RyanHailey21/neuromorphic-IR-hand-assembled/docs/images/board_iso.png

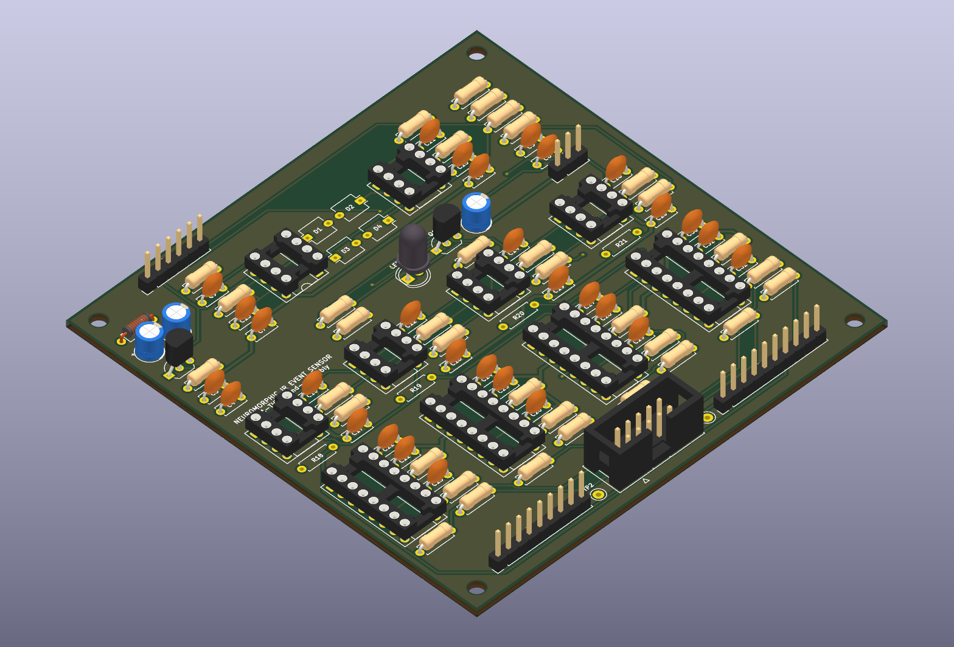
docs/images/board_iso.png
