RyanHailey21/neuromorphic-IR-hand-assembled/production/neuromorphic-ir-sensor-tht-BOM.csv

Qty | Value | References | Part / MPN | Function | Footprint | DNP
3 | 10uF | C1,C2,C33 | 10uF 16V radial electrolytic | Analog bulk,LED local bulk,Logic / one-shot bulk | Capacitor_THT:CP_Radial_D5.0mm_P2.00mm
1 | 1uF | C3 | 1uF X7R radial | Reference decoupling | Capacitor_THT:C_Disc_D5.0mm_W2.5mm_P5.00mm
17 | 100nF | C4-C8,C10,C12,C14,C16-C21,C24,C27,C30 |  | Adaptation CA (swap 47n/220n),Reference decoupling,Threshold filter,U10 decoupling,U11 decoupling,U2 decoupling,U3 decoupling,U4 decoupling,U5 decoupling,U6 decoupling,U7 decoupling,U8 decoupling,U9 decoupling | Capacitor_THT:C_Disc_D5.0mm_W2.5mm_P5.00mm
4 | 47pF C0G | C9,C11,C13,C15 | 47pF C0G radial | TIA feedback CF | Capacitor_THT:C_Disc_D5.0mm_W2.5mm_P5.00mm
8 | 12nF C0G | C22,C23,C25,C26,C28,C29,C31,C32 | 12nF C0G radial or film | One-shot timing C | Capacitor_THT:C_Disc_D5.0mm_W2.5mm_P5.00mm
4 | BPW34F | D1-D4 | ams OSRAM BPW 34 F (THT, daylight filter); alt Vishay BPW34 | IR photodiode BL (cathode to TIA input),IR photodiode BR (cathode to TIA input),IR photodiode TL (cathode to TIA input),IR photodiode TR (cathode to TIA input) | OptoDevice:Osram_DIL2_4.3x4.65mm_P5.08mm
1 | 600R@100MHz | FB1 | Axial ferrite bead (e.g. Fair-Rite 2743001112) | Analog rail filter bead | Inductor_THT:L_Axial_L5.3mm_D2.2mm_P7.62mm_Horizontal_Vishay_IM-1
1 | FPGA | J1 | 2x5 2.54mm shrouded box header | Keyed 2x5 event header to Tang Nano 20K | Connector_IDC:IDC-Header_2x05_P2.54mm_Vertical
1 | DEBUG | J2 |  | Analog debug header | Connector_PinHeader_2.54mm:PinHeader_1x06_P2.54mm_Vertical
1 | LED_EN | J3 |  | Jumper 1-2 = LED on, 2-3 = off, or drive pin 2 from FPGA | Connector_PinHeader_2.54mm:PinHeader_1x03_P2.54mm_Vertical
1 | RAW_PROBE | J4 |  | Raw comparator probe header | Connector_PinHeader_2.54mm:PinHeader_1x09_P2.54mm_Vertical
1 | EVENT_PROBE | J5 |  | Rail / threshold / event-node probe header | Connector_PinHeader_2.54mm:PinHeader_1x10_P2.54mm_Vertical
1 | TSAL6200 | LED1 | Vishay TSAL6200 | 940 nm IR emitter | LED_THT:LED_D5.0mm_IRGrey
1 | PN2222A | Q1 | PN2222A | LED low-side switch | Package_TO_SOT_THT:TO-92_Inline_Wide
1 | 4.7k | R1 |  | Reference bias ~0.44 mA | Resistor_THT:R_Axial_DIN0207_L6.3mm_D2.5mm_P7.62mm_Horizontal
1 | 499k 0.1% | R2 |  | ON threshold upper | Resistor_THT:R_Axial_DIN0207_L6.3mm_D2.5mm_P7.62mm_Horizontal
2 | 10k 0.1% | R3,R4 |  | OFF threshold upper,ON threshold lower | Resistor_THT:R_Axial_DIN0207_L6.3mm_D2.5mm_P7.62mm_Horizontal
1 | 301k 0.1% | R5 |  | OFF threshold lower | Resistor_THT:R_Axial_DIN0207_L6.3mm_D2.5mm_P7.62mm_Horizontal
4 | 18k 0.1% | R6,R9,R12,R15 |  | TIA feedback RF | Resistor_THT:R_Axial_DIN0207_L6.3mm_D2.5mm_P7.62mm_Horizontal
4 | 22k | R7,R10,R13,R16 |  | Adaptation RA (swap 10k/47k) | Resistor_THT:R_Axial_DIN0207_L6.3mm_D2.5mm_P7.62mm_Horizontal
4 | 100 | R8,R11,R14,R17 |  | Debug header series R | Resistor_THT:R_Axial_DIN0207_L6.3mm_D2.5mm_P7.62mm_Horizontal
4 | 1M | R18-R21 |  | Optional ON hysteresis (DNP) | Resistor_THT:R_Axial_DIN0207_L6.3mm_D2.5mm_P7.62mm_Horizontal | DNP
8 | 18k | R22,R24,R26,R28,R30,R32,R34,R36 |  | One-shot timing R (~100 us) | Resistor_THT:R_Axial_DIN0207_L6.3mm_D2.5mm_P7.62mm_Horizontal
8 | 150 | R23,R25,R27,R29,R31,R33,R35,R37 |  | Spike series R | Resistor_THT:R_Axial_DIN0207_L6.3mm_D2.5mm_P7.62mm_Horizontal
1 | 82 | R38 |  | LED current (~22 mA) - tuning 68/100/150 | Resistor_THT:R_Axial_DIN0207_L6.3mm_D2.5mm_P7.62mm_Horizontal
1 | 1k | R39 |  | Base resistor | Resistor_THT:R_Axial_DIN0207_L6.3mm_D2.5mm_P7.62mm_Horizontal
1 | 100k | R40 |  | LED_EN pulldown | Resistor_THT:R_Axial_DIN0207_L6.3mm_D2.5mm_P7.62mm_Horizontal
2 | GND | TP1,TP2 |  | Scope ground loop | TestPoint:TestPoint_Keystone_5000-5004_Miniature
1 | LM385BZ-1.2 | U1 | LM385BZ-1.2 | 1.235 V shunt reference (VREF) | Package_TO_SOT_THT:TO-92_Inline_Wide
2 | MCP6022 | U2,U3 | MCP6022-I/P | Dual RRIO CMOS op-amp (TIA) | Package_DIP:DIP-8_W7.62mm_Socket
4 | MCP6542 | U4-U7 | MCP6542-I/P | Dual push-pull comparator, ON (A) / OFF (B) | Package_DIP:DIP-8_W7.62mm_Socket
4 | 74HC123 | U8-U11 | 74HC123 (SN74HC123N / 74HC123N) | Dual retriggerable monostable, ON (A) / OFF (B) | Package_DIP:DIP-16_W7.62mm_Socket
