RyanHailey21/neuromorphic-IR-hand-assembled/docs/schematic.pdf

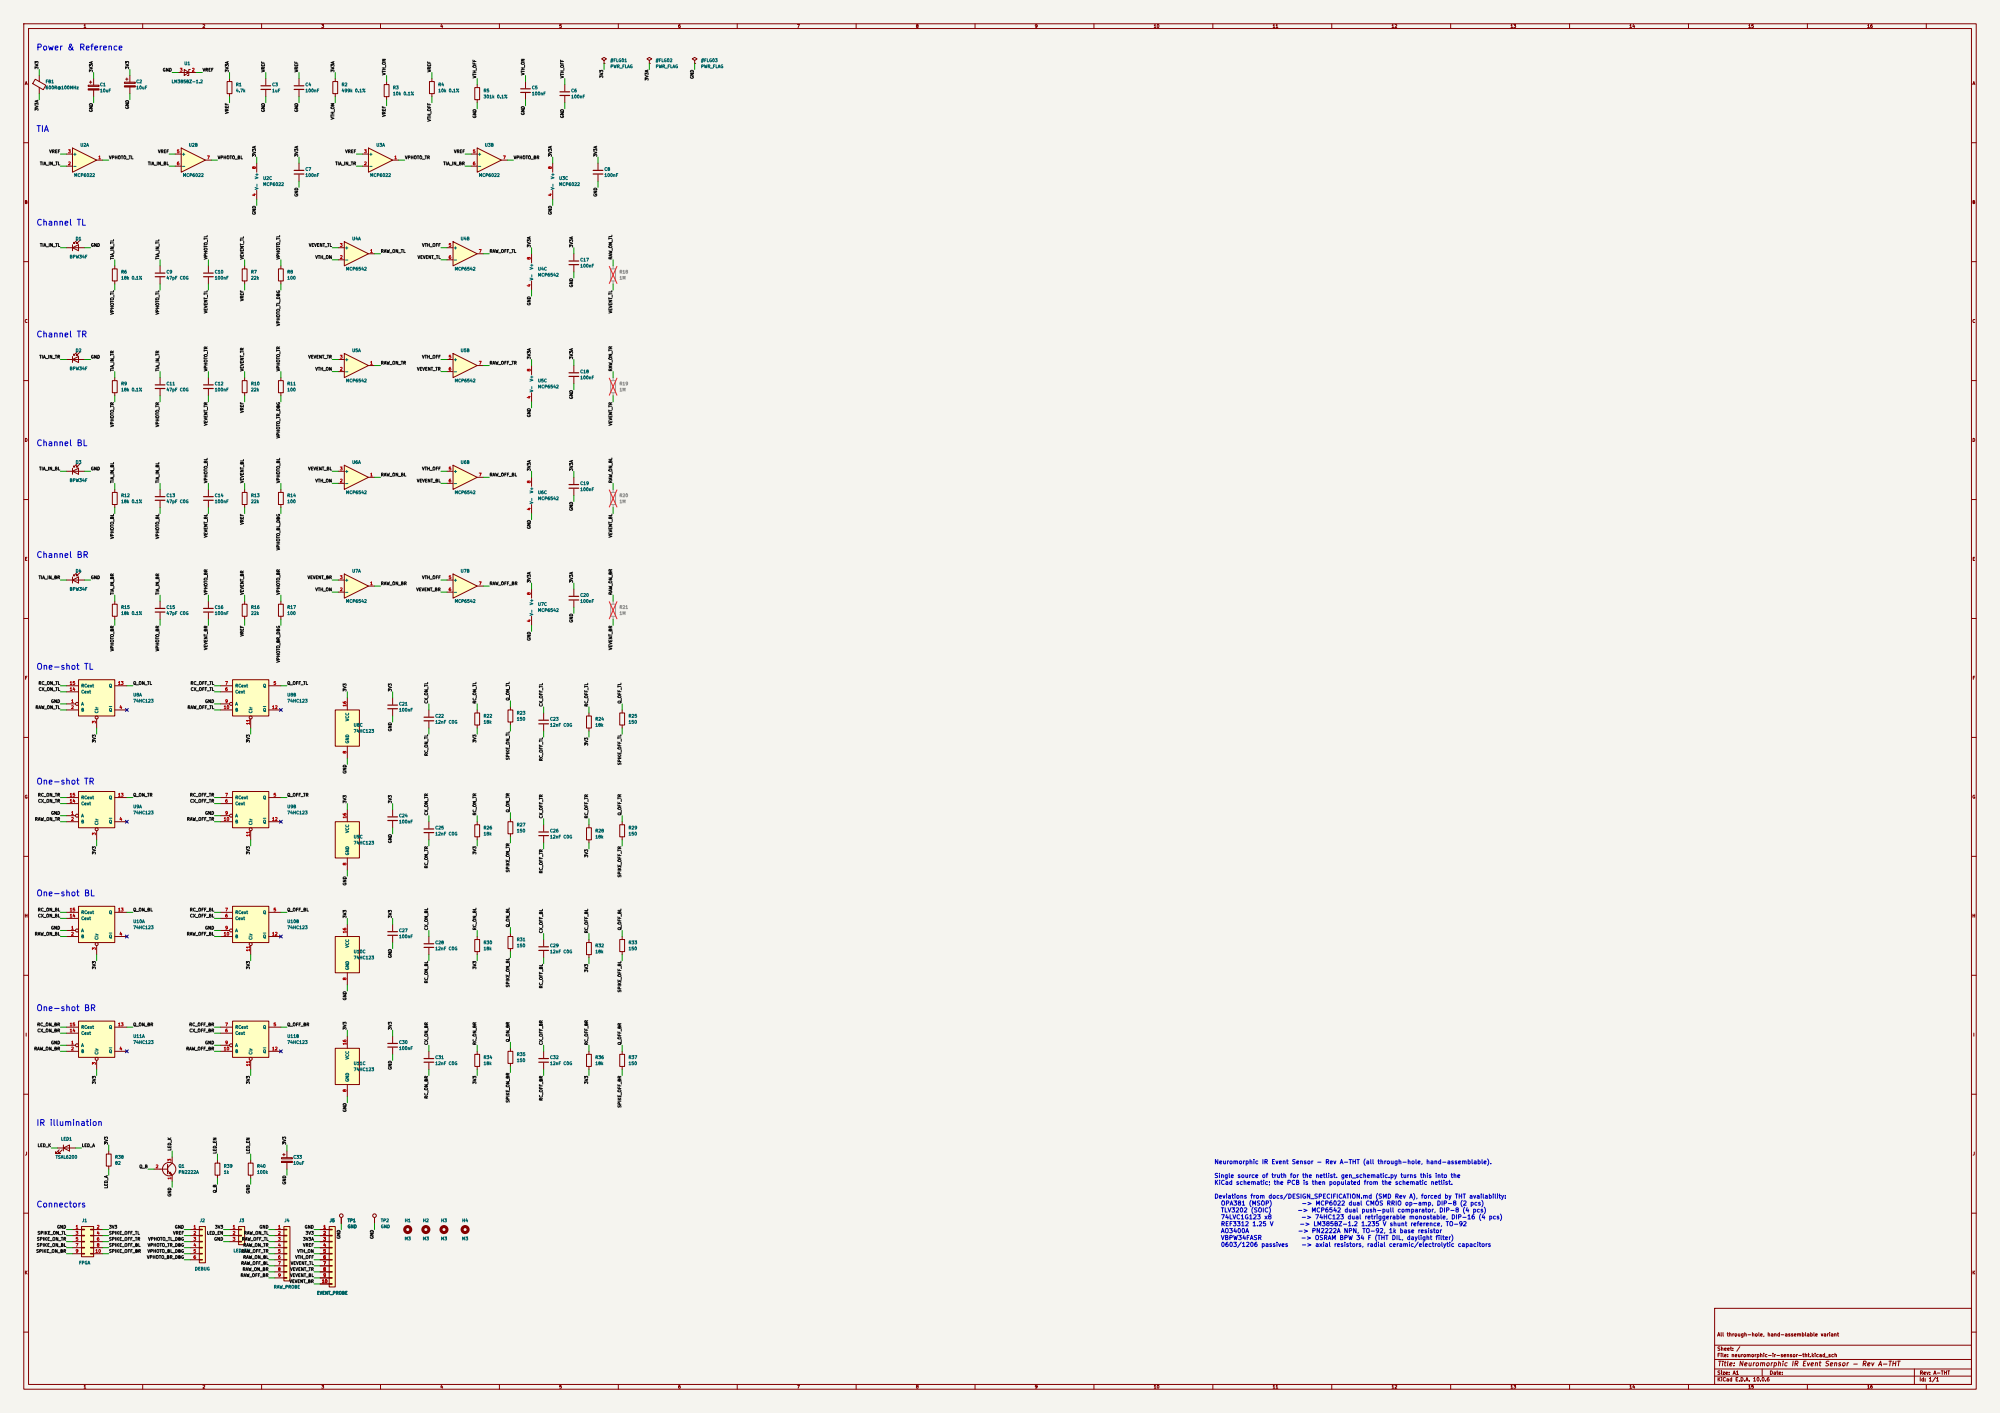
[picture p3: page 1]

Neuromorphic IR Event Sensor - Rev A-THT (all through-hole, hand-assemblable).

Single source of truth for the netlist. gen_schematic.py turns this into the
KiCad schematic; the PCB is then populated from the schematic netlist.

Deviations from docs/DESIGN_SPECIFICATION.md (SMD Rev A), forced by THT availability:

All through-hole, hand-assemblable variant

Sheet: /
File: neuromorphic-ir-sensor-tht.kicad_sch
Title: Neuromorphic IR Event Sensor - Rev A-THT

Size: A1 | Rev: A-THT
KiCad E.D.A. 10.0.6 | Id: 1/1
