RyanHailey21/neuromorphic-IR-hand-assembled/docs/assembly_top.pdf

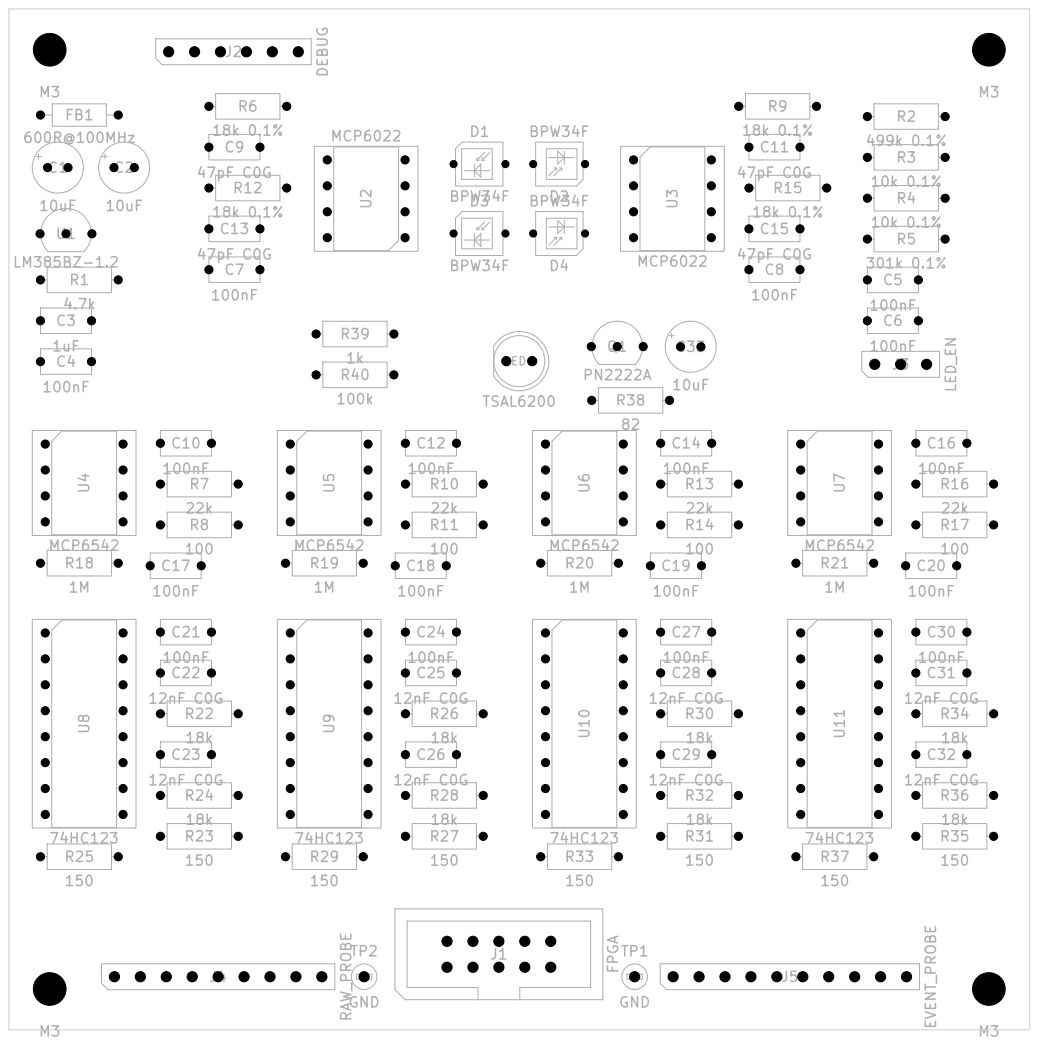
[picture p4: page 1]
