RyanHailey21/neuromorphic-IR-hand-assembled/neuromorphic-ir-sensor-tht.kicad_pcb

## KiCad design neuromorphic-ir-sensor-tht.kicad_pcb (2026-09-27)

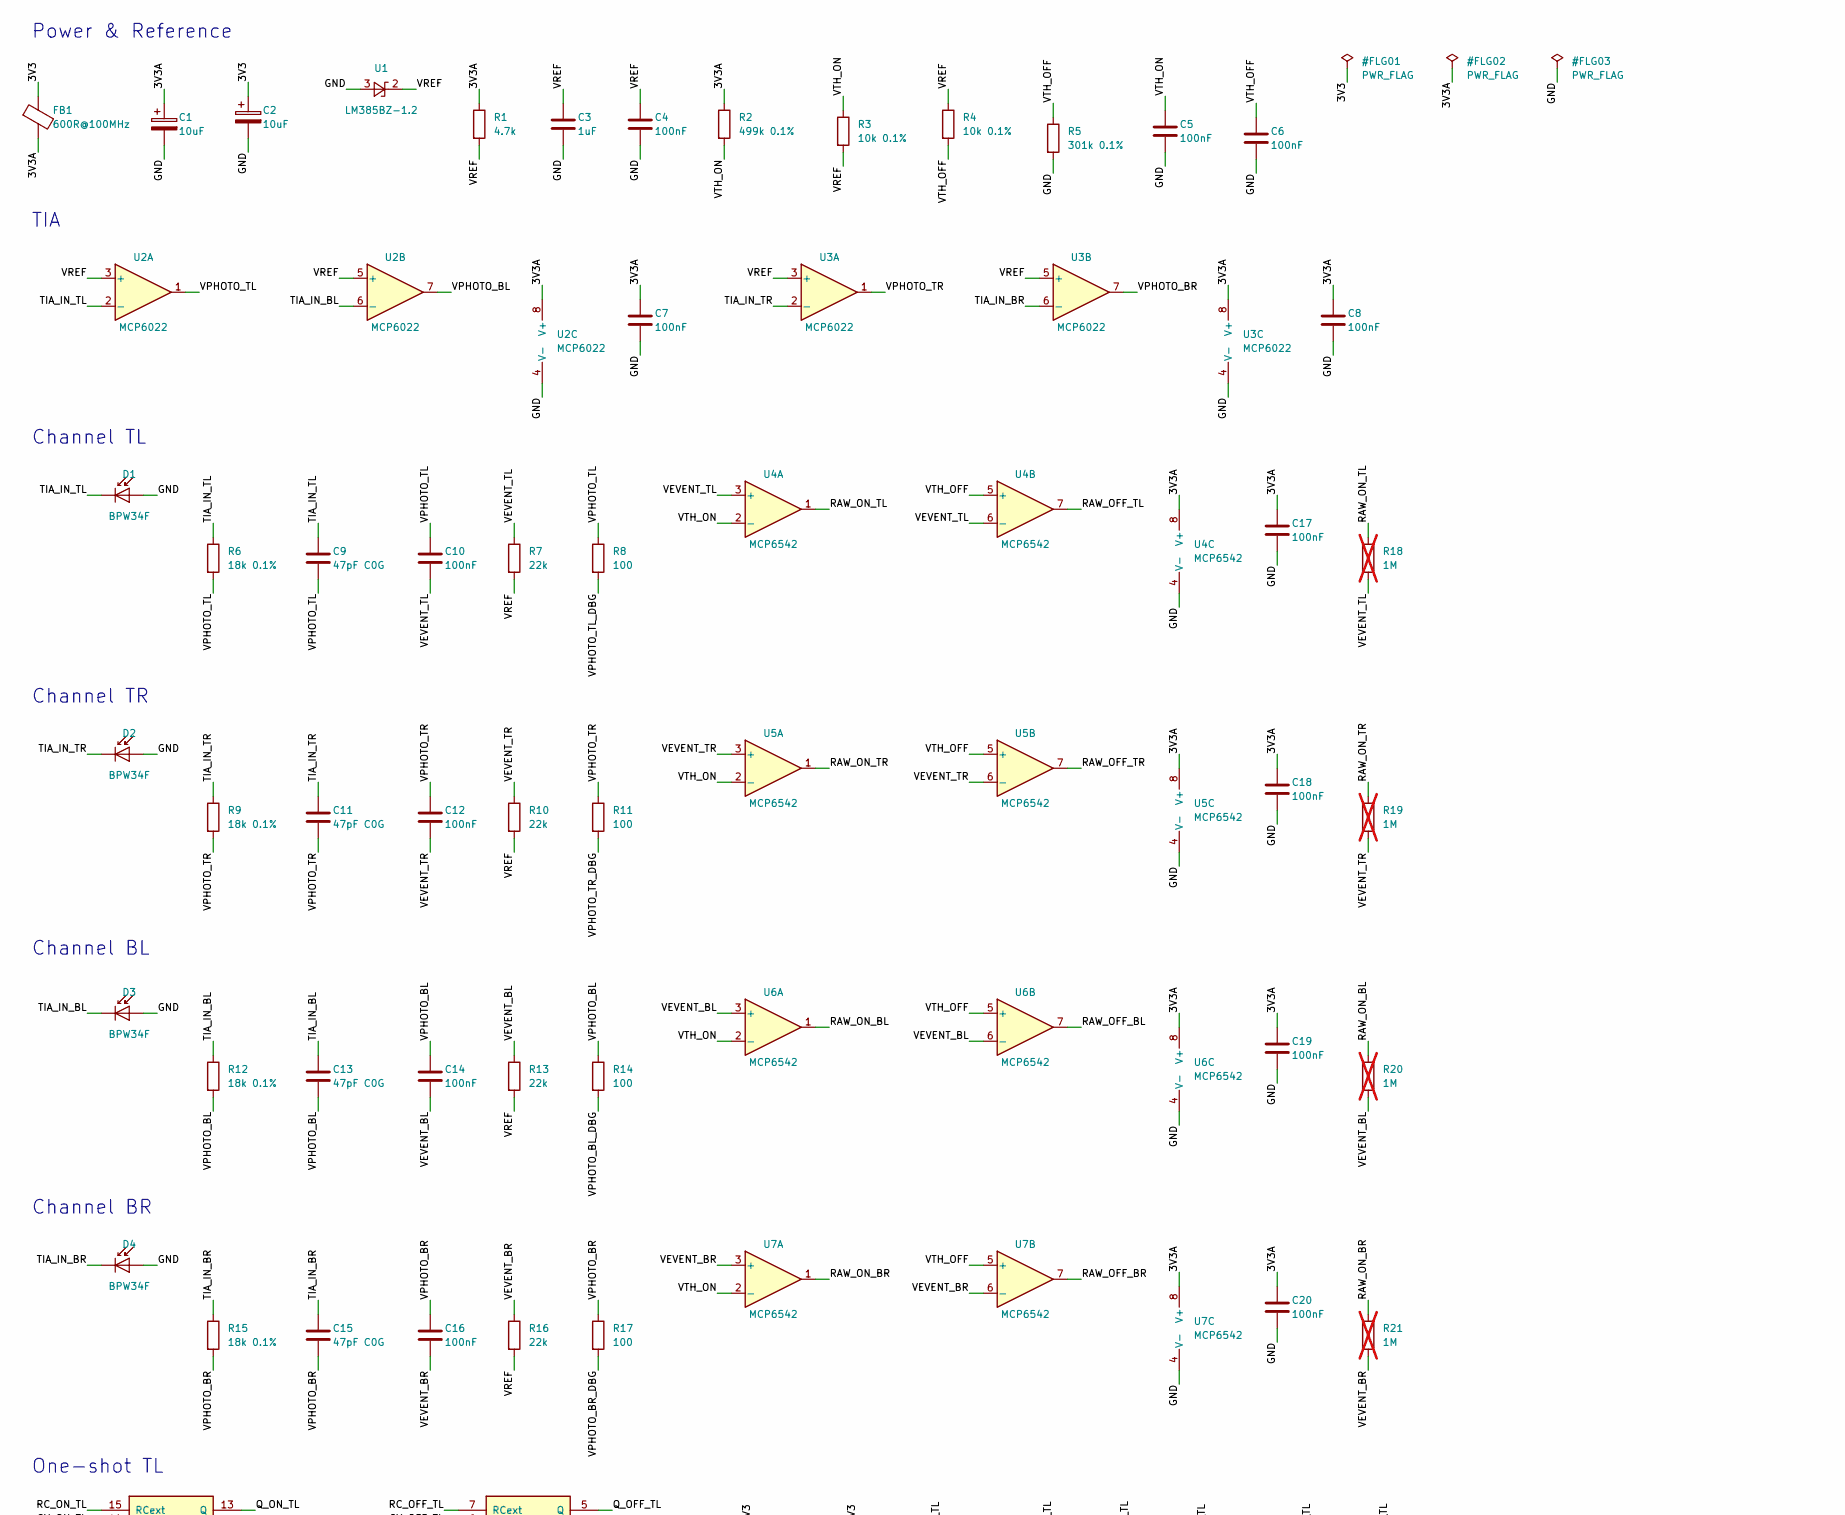
[picture p5: schematic neuromorphic-ir-sensor-tht.kicad_sch, Neuromorphic IR Event Sensor - Rev A-THT, part in row 1, column 1]

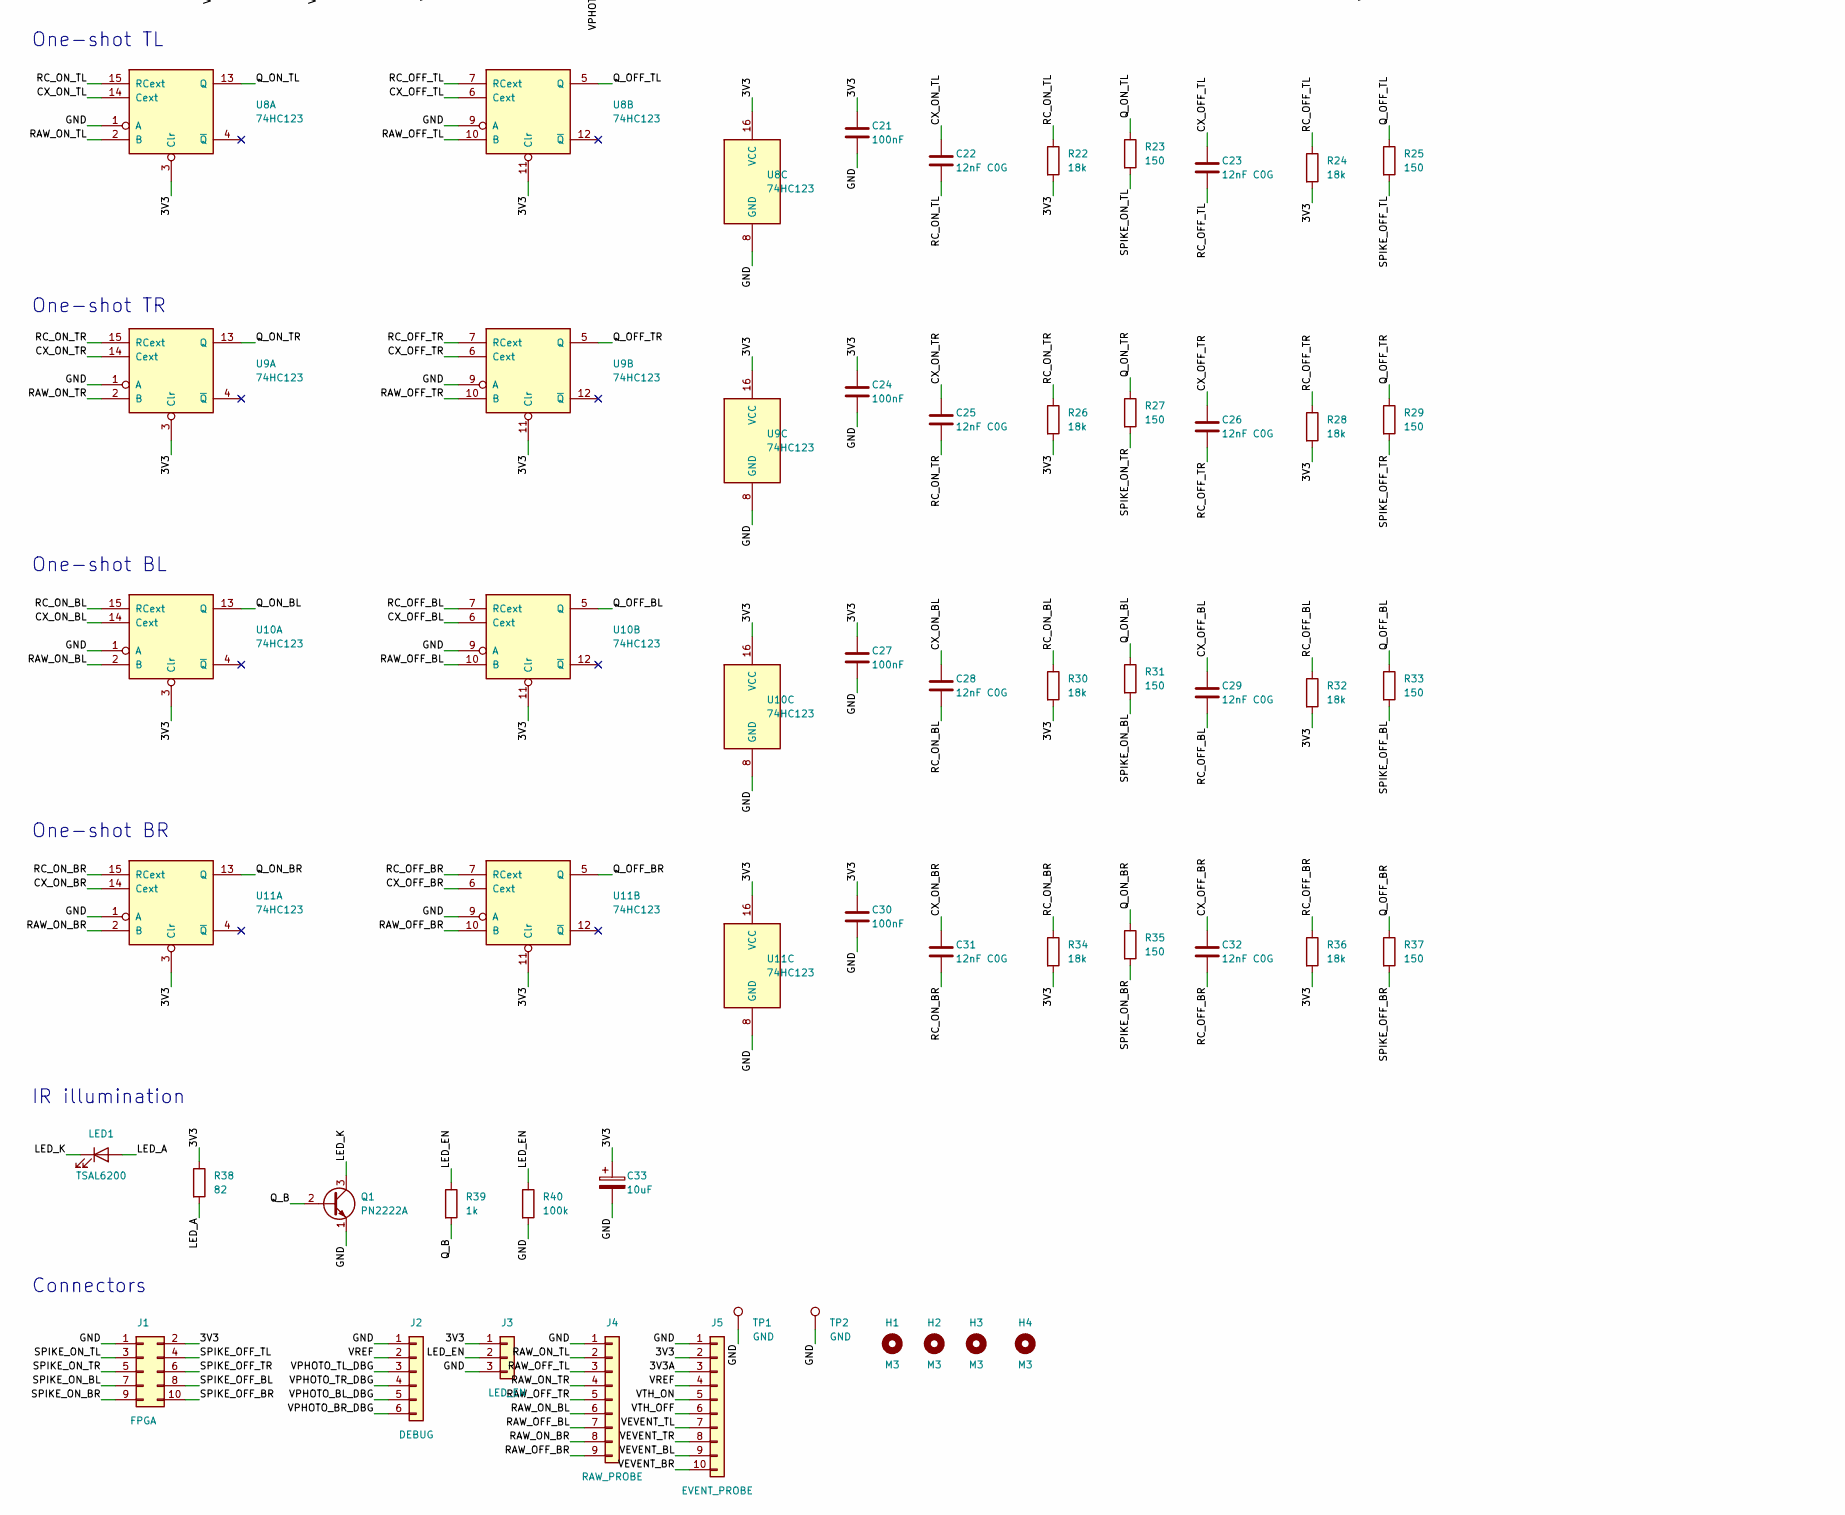
[picture p6: schematic neuromorphic-ir-sensor-tht.kicad_sch, Neuromorphic IR Event Sensor - Rev A-THT, part in row 2, column 1]

Parts:
C1, C2, C33: 10uF; CP_Radial_D5.0mm_P2.00mm; MPN 10uF 16V radial electrolytic
C3: 1uF; C_Disc_D5.0mm_W2.5mm_P5.00mm; MPN 1uF X7R radial
C4, C5, C6, C7, C8, C10, C12, C14, C16, C17, C18, C19, C20, C21, C24, C27, C30: 100nF; C_Disc_D5.0mm_W2.5mm_P5.00mm
C9, C11, C13, C15: 47pF C0G; C_Disc_D5.0mm_W2.5mm_P5.00mm; MPN 47pF C0G radial
C22, C23, C25, C26, C28, C29, C31, C32: 12nF C0G; C_Disc_D5.0mm_W2.5mm_P5.00mm; MPN 12nF C0G radial or film
D1, D2, D3, D4: BPW34F; Osram_DIL2_4.3x4.65mm_P5.08mm; MPN ams OSRAM BPW 34 F (THT, daylight filte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
FB1: 600R@100MHz; L_Axial_L5.3mm_D2.2mm_P7.62mm_Horizontal_Vishay_IM-1; MPN Axial ferrite bead (e.g. Fair-Rite 2743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
H1, H2, H3, H4: M3; MountingHole_3.2mm_M3
J1: FPGA; IDC-Header_2x05_P2.54mm_Vertical; MPN 2x5 2.54mm shrouded box header
J2: DEBUG; PinHeader_1x06_P2.54mm_Vertical
J3: LED_EN; PinHeader_1x03_P2.54mm_Vertical
J4: RAW_PROBE; PinHeader_1x09_P2.54mm_Vertical
J5: EVENT_PROBE; PinHeader_1x10_P2.54mm_Vertical
LED1: TSAL6200; LED_D5.0mm_IRGrey; MPN Vishay TSAL6200
Q1: PN2222A; TO-92_Inline_Wide; MPN PN2222A
R1: 4.7k; R_Axial_DIN0207_L6.3mm_D2.5mm_P7.62mm_Horizontal
R2: 499k 0.1%; R_Axial_DIN0207_L6.3mm_D2.5mm_P7.62mm_Horizontal
R3, R4: 10k 0.1%; R_Axial_DIN0207_L6.3mm_D2.5mm_P7.62mm_Horizontal
R5: 301k 0.1%; R_Axial_DIN0207_L6.3mm_D2.5mm_P7.62mm_Horizontal
R6, R9, R12, R15: 18k 0.1%; R_Axial_DIN0207_L6.3mm_D2.5mm_P7.62mm_Horizontal
R7, R10, R13, R16: 22k; R_Axial_DIN0207_L6.3mm_D2.5mm_P7.62mm_Horizontal
R8, R11, R14, R17: 100; R_Axial_DIN0207_L6.3mm_D2.5mm_P7.62mm_Horizontal
R18, R19, R20, R21: 1M; R_Axial_DIN0207_L6.3mm_D2.5mm_P7.62mm_Horizontal; not fitted
R22, R24, R26, R28, R30, R32, R34, R36: 18k; R_Axial_DIN0207_L6.3mm_D2.5mm_P7.62mm_Horizontal
R23, R25, R27, R29, R31, R33, R35, R37: 150; R_Axial_DIN0207_L6.3mm_D2.5mm_P7.62mm_Horizontal
R38: 82; R_Axial_DIN0207_L6.3mm_D2.5mm_P7.62mm_Horizontal
R39: 1k; R_Axial_DIN0207_L6.3mm_D2.5mm_P7.62mm_Horizontal
R40: 100k; R_Axial_DIN0207_L6.3mm_D2.5mm_P7.62mm_Horizontal
TP1, TP2: GND; TestPoint_Keystone_5000-5004_Miniature
U1: LM385BZ-1.2; TO-92_Inline_Wide; MPN LM385BZ-1.2
U2, U3: MCP6022; DIP-8_W7.62mm_Socket; MPN MCP6022-I/P
U4, U5, U6, U7: MCP6542; DIP-8_W7.62mm_Socket; MPN MCP6542-I/P
U8, U9, U10, U11: 74HC123; DIP-16_W7.62mm_Socket; MPN 74HC123 (SN74HC123N / 74HC123N)

Connections:
/3V3: C2.1, C21.1, C24.1, C27.1, C30.1, C33.1, FB1.1, J1.2, J3.1, J5.2, R22.2, R24.2, R26.2, R28.2, R30.2, R32.2, R34.2, R36.2, R38.1, U8.3 (Clr), U8.11 (Clr), U8.16 (VCC), U9.3 (Clr), U9.11 (Clr), U9.16 (VCC), U10.3 (Clr), U10.11 (Clr), U10.16 (VCC), U11.3 (Clr), U11.11 (Clr), U11.16 (VCC)
/3V3A: C1.1, C7.1, C8.1, C17.1, C18.1, C19.1, C20.1, FB1.2, J5.3, R1.1, R2.1, U2.8 (V+), U3.8 (V+), U4.8 (V+), U5.8 (V+), U6.8 (V+), U7.8 (V+)
/CX_OFF_BL: C29.1, U10.6 (Cext)
/CX_OFF_BR: C32.1, U11.6 (Cext)
/CX_OFF_TL: C23.1, U8.6 (Cext)
/CX_OFF_TR: C26.1, U9.6 (Cext)
/CX_ON_BL: C28.1, U10.14 (Cext)
/CX_ON_BR: C31.1, U11.14 (Cext)
/CX_ON_TL: C22.1, U8.14 (Cext)
/CX_ON_TR: C25.1, U9.14 (Cext)
/GND: C1.2, C2.2, C3.2, C4.2, C5.2, C6.2, C7.2, C8.2, C17.2, C18.2, C19.2, C20.2, C21.2, C24.2, C27.2, C30.2, C33.2, D1.2 (A), D2.2 (A), D3.2 (A), D4.2 (A), J1.1, J2.1, J3.3, J4.1, J5.1, Q1.1 (E), R5.2, R40.2, TP1.1, TP2.1, U1.3 (A), U2.4 (V-), U3.4 (V-), U4.4 (V-), U5.4 (V-), U6.4 (V-), U7.4 (V-), U8.1 (A), U8.8 (GND), U8.9 (A), U9.1 (A), U9.8 (GND), U9.9 (A), U10.1 (A), U10.8 (GND), U10.9 (A), U11.1 (A), U11.8 (GND), U11.9 (A)
/LED_A: LED1.2 (A), R38.2
/LED_EN: J3.2, R39.1, R40.1
/LED_K: LED1.1 (K), Q1.3 (C)
/Q_B: Q1.2 (B), R39.2
/Q_OFF_BL: R33.1, U10.5 (Q)
/Q_OFF_BR: R37.1, U11.5 (Q)
/Q_OFF_TL: R25.1, U8.5 (Q)
/Q_OFF_TR: R29.1, U9.5 (Q)
/Q_ON_BL: R31.1, U10.13 (Q)
/Q_ON_BR: R35.1, U11.13 (Q)
/Q_ON_TL: R23.1, U8.13 (Q)
/Q_ON_TR: R27.1, U9.13 (Q)
/RAW_OFF_BL: J4.7, U6.7, U10.10 (B)
/RAW_OFF_BR: J4.9, U7.7, U11.10 (B)
/RAW_OFF_TL: J4.3, U4.7, U8.10 (B)
/RAW_OFF_TR: J4.5, U5.7, U9.10 (B)
/RAW_ON_BL: J4.6, R20.1, U6.1, U10.2 (B)
/RAW_ON_BR: J4.8, R21.1, U7.1, U11.2 (B)
/RAW_ON_TL: J4.2, R18.1, U4.1, U8.2 (B)
/RAW_ON_TR: J4.4, R19.1, U5.1, U9.2 (B)
/RC_OFF_BL: C29.2, R32.1, U10.7 (RCext)
/RC_OFF_BR: C32.2, R36.1, U11.7 (RCext)
/RC_OFF_TL: C23.2, R24.1, U8.7 (RCext)
/RC_OFF_TR: C26.2, R28.1, U9.7 (RCext)
/RC_ON_BL: C28.2, R30.1, U10.15 (RCext)
/RC_ON_BR: C31.2, R34.1, U11.15 (RCext)
/RC_ON_TL: C22.2, R22.1, U8.15 (RCext)
/RC_ON_TR: C25.2, R26.1, U9.15 (RCext)
/SPIKE_OFF_BL: J1.8, R33.2
/SPIKE_OFF_BR: J1.10, R37.2
/SPIKE_OFF_TL: J1.4, R25.2
/SPIKE_OFF_TR: J1.6, R29.2
/SPIKE_ON_BL: J1.7, R31.2
/SPIKE_ON_BR: J1.9, R35.2
/SPIKE_ON_TL: J1.3, R23.2
/SPIKE_ON_TR: J1.5, R27.2
/TIA_IN_BL: C13.1, D3.1 (K), R12.1, U2.6 (-)
/TIA_IN_BR: C15.1, D4.1 (K), R15.1, U3.6 (-)
/TIA_IN_TL: C9.1, D1.1 (K), R6.1, U2.2 (-)
/TIA_IN_TR: C11.1, D2.1 (K), R9.1, U3.2 (-)
/VEVENT_BL: C14.2, J5.9, R13.1, R20.2, U6.3 (+), U6.6 (-)
/VEVENT_BR: C16.2, J5.10, R16.1, R21.2, U7.3 (+), U7.6 (-)
/VEVENT_TL: C10.2, J5.7, R7.1, R18.2, U4.3 (+), U4.6 (-)
/VEVENT_TR: C12.2, J5.8, R10.1, R19.2, U5.3 (+), U5.6 (-)
/VPHOTO_BL: C13.2, C14.1, R12.2, R14.1, U2.7
/VPHOTO_BL_DBG: J2.5, R14.2
/VPHOTO_BR: C15.2, C16.1, R15.2, R17.1, U3.7
/VPHOTO_BR_DBG: J2.6, R17.2
/VPHOTO_TL: C9.2, C10.1, R6.2, R8.1, U2.1
/VPHOTO_TL_DBG: J2.3, R8.2
/VPHOTO_TR: C11.2, C12.1, R9.2, R11.1, U3.1
/VPHOTO_TR_DBG: J2.4, R11.2
/VREF: C3.1, C4.1, J2.2, J5.4, R1.2, R3.2, R4.1, R7.2, R10.2, R13.2, R16.2, U1.2 (K), U2.3 (+), U2.5 (+), U3.3 (+), U3.5 (+)
/VTH_OFF: C6.1, J5.6, R4.2, R5.1, U4.5 (+), U5.5 (+), U6.5 (+), U7.5 (+)
/VTH_ON: C5.1, J5.5, R2.2, R3.1, U4.2 (-), U5.2 (-), U6.2 (-), U7.2 (-)

Notes on the sheet:
Power & Reference
TIA
Channel TL
Channel TR
Channel BL
Channel BR
One-shot TL
One-shot TR
One-shot BL
One-shot BR
IR illumination
Connectors
Neuromorphic IR Event Sensor - Rev A-THT (all through-hole, hand-assemblable). Single source of truth for the netlist. gen_schematic.py turns this into the KiCad schematic; the PCB is then populated from the schematic netlist. Deviations from docs/DESIGN_SPECIFICATION.md (SMD Rev A), forced by THT 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

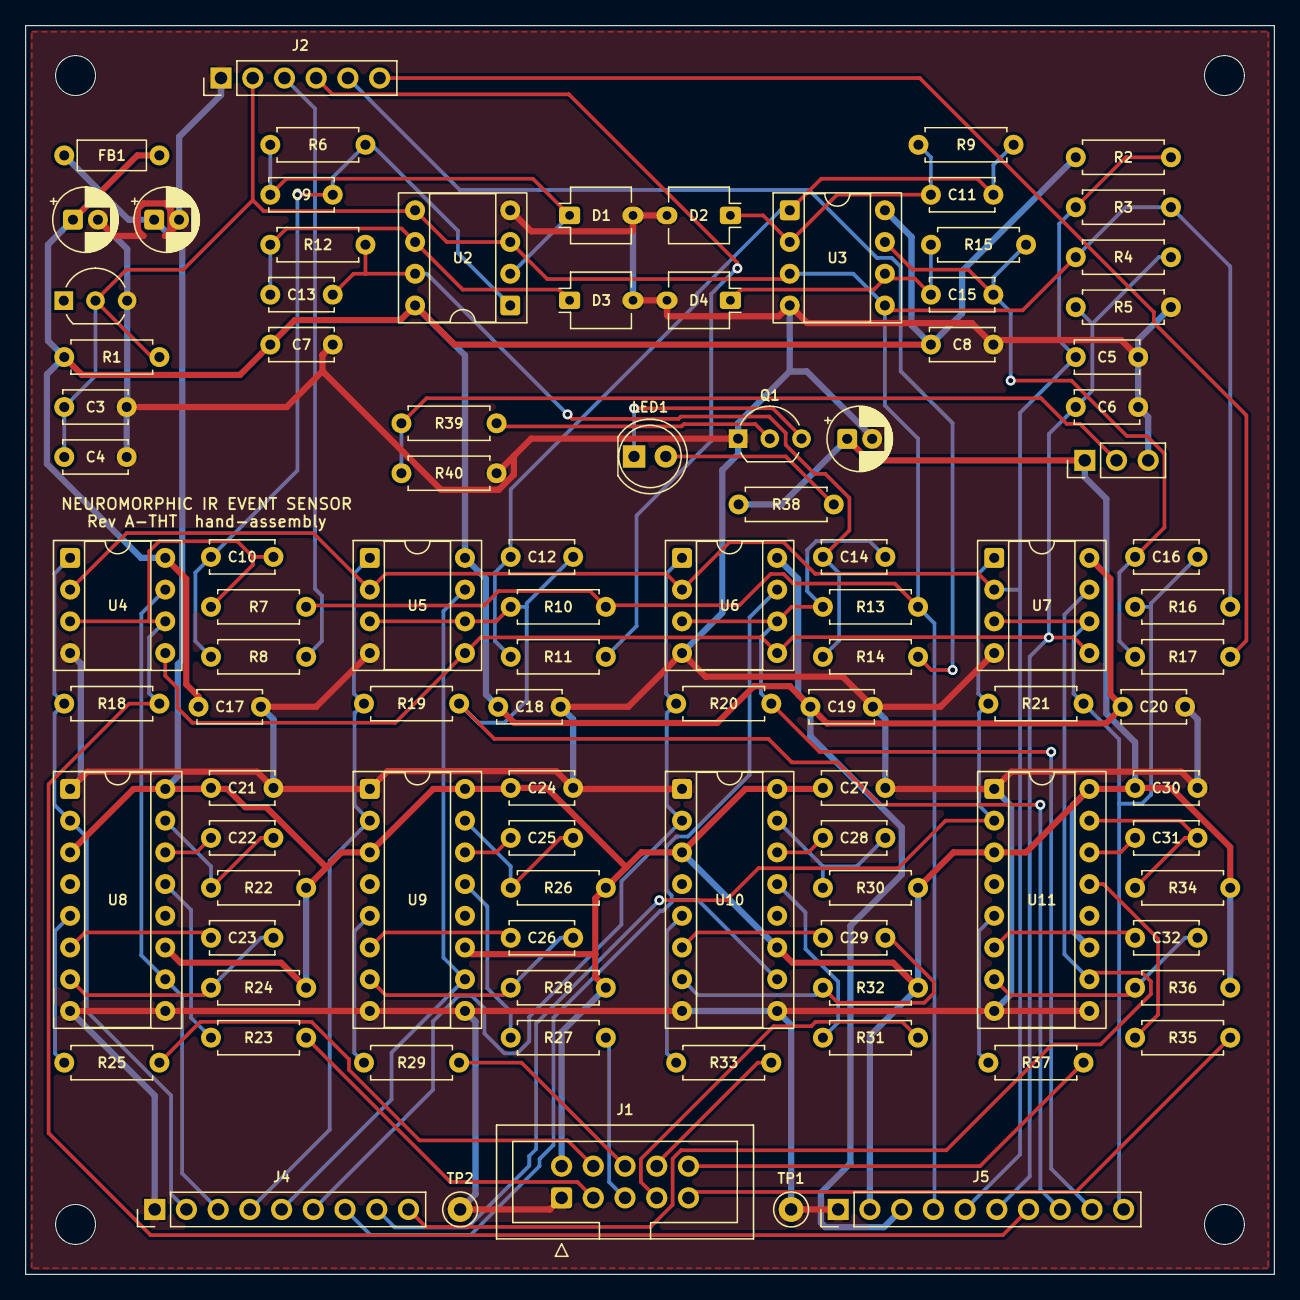
[picture p7: board neuromorphic-ir-sensor-tht.kicad_pcb from above]

Board: 2 copper layers, 100.0 x 100.0 mm, 102 parts (0 on the bottom side), 66 nets.
