RyanHailey21/neuromorphic-IR-hand-assembled/compact/neuromorphic-ir-sensor-compact.kicad_pcb

## KiCad design compact/neuromorphic-ir-sensor-compact.kicad_pcb (2026-09-27)

Schematic: neuromorphic-ir-sensor-compact.kicad_sch, Neuromorphic IR Event Sensor - Rev A-C (compact)

Parts:
C1, C2, C38: 10uF; C_0402_1005Metric; MPN GRM155R60J106ME15D
C3, C5, C6, C7, C8, C9, C11, C13, C15, C17, C18, C19, C20, C21, C22, C24, C26, C28, C30, C32, C34, C36: 100nF; C_0201_0603Metric; MPN GRM033R71A104KA01D
C4: 1uF; C_0201_0603Metric; MPN GRM033R60J105MEA2D
C10, C12, C14, C16: 47pF; C_0201_0603Metric; MPN GRM0335C1H470JA01D
C23, C25, C27, C29, C31, C33, C35, C37: 1nF; C_0201_0603Metric; MPN GRM0335C1H102JA01D
D1, D2, D3, D4: BPW 34 FAS; Osram_BPW34S-SMD; MPN BPW 34 FAS
FB1: 600R@100MHz; L_0402_1005Metric; MPN BLM15AG601SN1D
H1, H2: M2; MountingHole_2.2mm_M2
J1: FPGA; PinHeader_2x05_P1.27mm_Vertical_SMD; MPN 2x5 1.27mm SMD pin header, gold
JP1: LED_EN; SolderJumper-3_P1.3mm_Bridged12_Pad1.0x1.5mm
LED1: TSAL6200; LED_D5.0mm_IRGrey; MPN TSAL6200
Q1: AO3400A; SOT-23; MPN AO3400A
R1: 499k 0.1%; R_0402_1005Metric; MPN 499k 0.1% 0402 thin film
R2, R3: 10k 0.1%; R_0402_1005Metric; MPN 10k 0.1% 0402 thin film
R4: 301k 0.1%; R_0402_1005Metric; MPN 301k 0.1% 0402 thin film
R5, R7, R9, R11: 18k 0.1%; R_0201_0603Metric; MPN 18k 0.1% 0201 thin film
R6, R8, R10, R12: 22k; R_0201_0603Metric; MPN 22k 0201 thick film 1%
R13, R14, R15, R16: 1M; R_0201_0603Metric; MPN 1M 0201 thick film 1%; not fitted
R17, R19, R21, R23, R25, R27, R29, R31, R35: 100k; R_0201_0603Metric; MPN 100k 0201 thick film 1%
R18, R20, R22, R24, R26, R28, R30, R32: 150; R_0201_0603Metric; MPN 150 0201 thick film 1%
R33: 82; R_0402_1005Metric; MPN 82R 0402 1% (62.5 mW)
R34: 100; R_0201_0603Metric; MPN 100 0201 thick film 1%
TP1: 3V3A; TestPoint_Pad_D1.0mm
TP2: GND; TestPoint_Pad_D1.0mm
TP3: VREF; TestPoint_Pad_D1.0mm
TP4: VTH_ON; TestPoint_Pad_D1.0mm
TP5: VTH_OFF; TestPoint_Pad_D1.0mm
TP6: LED_EN; TestPoint_Pad_D1.0mm
TP7: VPHOTO_TL; TestPoint_Pad_D1.0mm
TP8: VPHOTO_TR; TestPoint_Pad_D1.0mm
TP9: VPHOTO_BL; TestPoint_Pad_D1.0mm
TP10: VPHOTO_BR; TestPoint_Pad_D1.0mm
TP11: VEVENT_TL; TestPoint_Pad_D1.0mm
TP12: VEVENT_TR; TestPoint_Pad_D1.0mm
TP13: VEVENT_BL; TestPoint_Pad_D1.0mm
TP14: VEVENT_BR; TestPoint_Pad_D1.0mm
TP15: RAW_ON_TL; TestPoint_Pad_D1.0mm
TP16: RAW_OFF_TL; TestPoint_Pad_D1.0mm
TP17: RAW_ON_TR; TestPoint_Pad_D1.0mm
TP18: RAW_OFF_TR; TestPoint_Pad_D1.0mm
TP19: RAW_ON_BL; TestPoint_Pad_D1.0mm
TP20: RAW_OFF_BL; TestPoint_Pad_D1.0mm
TP21: RAW_ON_BR; TestPoint_Pad_D1.0mm
TP22: RAW_OFF_BR; TestPoint_Pad_D1.0mm
U1: REF3312AIDCKR; SOT-323_SC-70; MPN REF3312AIDCKR
U2, U3: OPA2381AIDRBR; VSON-8-1EP_3x3mm_P0.65mm_EP1.65x2.4mm; MPN OPA2381AIDRBR
U4, U5, U6, U7: TLV3202AIDGKR; VSSOP-8_3x3mm_P0.65mm; MPN TLV3202AIDGKR
U8, U9, U10, U11, U12, U13, U14, U15: SN74LVC1G123DCUR; VSSOP-8_2.3x2mm_P0.5mm; MPN SN74LVC1G123DCUR

Connections:
/3V3: C2.1, C22.1, C24.1, C26.1, C28.1, C30.1, C32.1, C34.1, C36.1, C38.1, FB1.1, J1.2, JP1.1 (A), R17.2, R19.2, R21.2, R23.2, R25.2, R27.2, R29.2, R31.2, R33.1, U8.3 (~CLR), U8.8 (VCC), U9.3 (~CLR), U9.8 (VCC), U10.3 (~CLR), U10.8 (VCC), U11.3 (~CLR), U11.8 (VCC), U12.3 (~CLR), U12.8 (VCC), U13.3 (~CLR), U13.8 (VCC), U14.3 (~CLR), U14.8 (VCC), U15.3 (~CLR), U15.8 (VCC)
/3V3A: C1.1, C3.1, C8.1, C9.1, C18.1, C19.1, C20.1, C21.1, FB1.2, R1.1, TP1.1, U1.1 (IN), U2.8 (V+), U3.8 (V+), U4.8 (V+), U5.8 (V+), U6.8 (V+), U7.8 (V+)
/CX_OFF_BL: C33.1, U13.6 (Cext)
/CX_OFF_BR: C37.1, U15.6 (Cext)
/CX_OFF_TL: C25.1, U9.6 (Cext)
/CX_OFF_TR: C29.1, U11.6 (Cext)
/CX_ON_BL: C31.1, U12.6 (Cext)
/CX_ON_BR: C35.1, U14.6 (Cext)
/CX_ON_TL: C23.1, U8.6 (Cext)
/CX_ON_TR: C27.1, U10.6 (Cext)
/GND: C1.2, C2.2, C3.2, C4.2, C5.2, C6.2, C7.2, C8.2, C9.2, C18.2, C19.2, C20.2, C21.2, C22.2, C24.2, C26.2, C28.2, C30.2, C32.2, C34.2, C36.2, C38.2, D1.2 (A), D2.2 (A), D3.2 (A), D4.2 (A), J1.1, JP1.3 (B), Q1.2 (S), R4.2, R35.2, TP2.1, U1.3 (GND), U2.4 (V-), U2.9 (EP), U3.4 (V-), U3.9 (EP), U4.4 (V-), U5.4 (V-), U6.4 (V-), U7.4 (V-), U8.1 (~A), U8.4 (GND), U9.1 (~A), U9.4 (GND), U10.1 (~A), U10.4 (GND), U11.1 (~A), U11.4 (GND), U12.1 (~A), U12.4 (GND), U13.1 (~A), U13.4 (GND), U14.1 (~A), U14.4 (GND), U15.1 (~A), U15.4 (GND)
/LED_A: LED1.2 (A), R33.2
/LED_EN: JP1.2 (C), R34.1, TP6.1
/LED_K: LED1.1 (K), Q1.3 (D)
/Q_G: Q1.1 (G), R34.2, R35.1
/Q_OFF_BL: R28.1, U13.5 (Q)
/Q_OFF_BR: R32.1, U15.5 (Q)
/Q_OFF_TL: R20.1, U9.5 (Q)
/Q_OFF_TR: R24.1, U11.5 (Q)
/Q_ON_BL: R26.1, U12.5 (Q)
/Q_ON_BR: R30.1, U14.5 (Q)
/Q_ON_TL: R18.1, U8.5 (Q)
/Q_ON_TR: R22.1, U10.5 (Q)
/RAW_OFF_BL: TP20.1, U6.7, U13.2 (B)
/RAW_OFF_BR: TP22.1, U7.7, U15.2 (B)
/RAW_OFF_TL: TP16.1, U4.7, U9.2 (B)
/RAW_OFF_TR: TP18.1, U5.7, U11.2 (B)
/RAW_ON_BL: R15.1, TP19.1, U6.1, U12.2 (B)
/RAW_ON_BR: R16.1, TP21.1, U7.1, U14.2 (B)
/RAW_ON_TL: R13.1, TP15.1, U4.1, U8.2 (B)
/RAW_ON_TR: R14.1, TP17.1, U5.1, U10.2 (B)
/RC_OFF_BL: C33.2, R27.1, U13.7 (RCext)
/RC_OFF_BR: C37.2, R31.1, U15.7 (RCext)
/RC_OFF_TL: C25.2, R19.1, U9.7 (RCext)
/RC_OFF_TR: C29.2, R23.1, U11.7 (RCext)
/RC_ON_BL: C31.2, R25.1, U12.7 (RCext)
/RC_ON_BR: C35.2, R29.1, U14.7 (RCext)
/RC_ON_TL: C23.2, R17.1, U8.7 (RCext)
/RC_ON_TR: C27.2, R21.1, U10.7 (RCext)
/SPIKE_OFF_BL: J1.8, R28.2
/SPIKE_OFF_BR: J1.10, R32.2
/SPIKE_OFF_TL: J1.4, R20.2
/SPIKE_OFF_TR: J1.6, R24.2
/SPIKE_ON_BL: J1.7, R26.2
/SPIKE_ON_BR: J1.9, R30.2
/SPIKE_ON_TL: J1.3, R18.2
/SPIKE_ON_TR: J1.5, R22.2
/TIA_IN_BL: C14.1, D3.1 (K), R9.1, U2.6 (-)
/TIA_IN_BR: C16.1, D4.1 (K), R11.1, U3.6 (-)
/TIA_IN_TL: C10.1, D1.1 (K), R5.1, U2.2 (-)
/TIA_IN_TR: C12.1, D2.1 (K), R7.1, U3.2 (-)
/VEVENT_BL: C15.2, R10.1, R15.2, TP13.1, U6.3 (+), U6.6 (-)
/VEVENT_BR: C17.2, R12.1, R16.2, TP14.1, U7.3 (+), U7.6 (-)
/VEVENT_TL: C11.2, R6.1, R13.2, TP11.1, U4.3 (+), U4.6 (-)
/VEVENT_TR: C13.2, R8.1, R14.2, TP12.1, U5.3 (+), U5.6 (-)
/VPHOTO_BL: C14.2, C15.1, R9.2, TP9.1, U2.7
/VPHOTO_BR: C16.2, C17.1, R11.2, TP10.1, U3.7
/VPHOTO_TL: C10.2, C11.1, R5.2, TP7.1, U2.1
/VPHOTO_TR: C12.2, C13.1, R7.2, TP8.1, U3.1
/VREF: C4.1, C5.1, R2.2, R3.1, R6.2, R8.2, R10.2, R12.2, TP3.1, U1.2 (OUT), U2.3 (+), U2.5 (+), U3.3 (+), U3.5 (+)
/VTH_OFF: C7.1, R3.2, R4.1, TP5.1, U4.5 (+), U5.5 (+), U6.5 (+), U7.5 (+)
/VTH_ON: C6.1, R1.2, R2.1, TP4.1, U4.2 (-), U5.2 (-), U6.2 (-), U7.2 (-)

Notes on the sheet:
Power & Reference
Photodiodes
TIA
Channel TL
Channel TR
Channel BL
Channel BR
One-shot TL
One-shot TR
One-shot BL
One-shot BR
IR illumination
Connectors
Test pads
Mechanical
Power flags
Neuromorphic IR Event Sensor - Rev A-C (compact, PCBWay-assembled). Smallest-footprint build of the Rev A spec. Writes compact/design/spec.json for kicad-companion's generate_schematic. Changes vs the SMD spec (docs/DESIGN_SPECIFICATION.md): OPA381 x4 (MSOP) -> OPA2381AIDRBR x2 (same amplifier, dua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

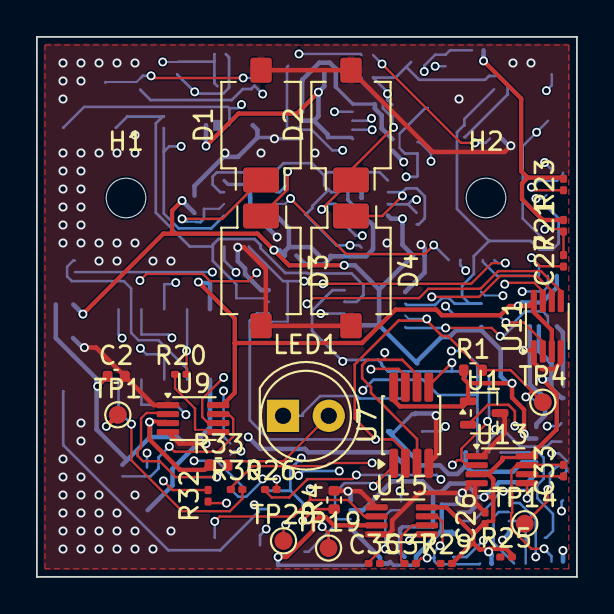
[picture p8: board neuromorphic-ir-sensor-compact.kicad_pcb from above]

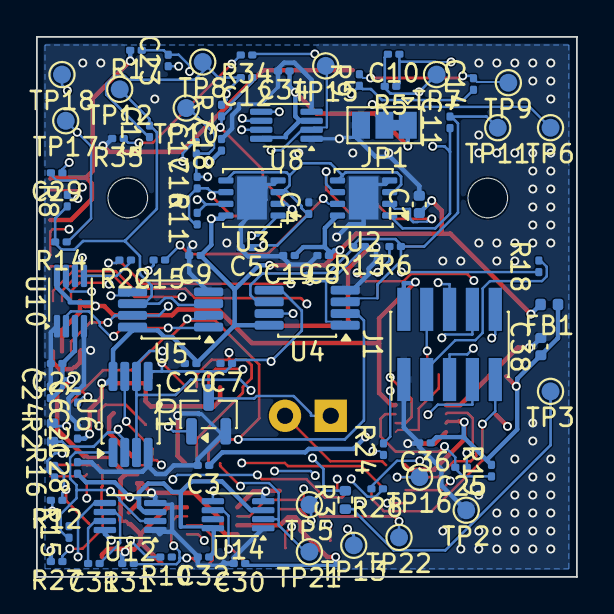
[picture p9: board neuromorphic-ir-sensor-compact.kicad_pcb from below]

Board: 4 copper layers, 30.0 x 30.0 mm, 121 parts (86 on the bottom side), 62 nets.
